Monash-BoSL/in_water_turbidity/README.md

# in_water_turbidity-
a repository for our in water turbidity sensor
