Monash-BoSL/in_water_turbidity/(commit log)

2023-07-21 added BOM
    [turbidity_sensor_v2.kicad_sch]
2023-07-21 added missing parts
    [turbidity_sensor_v2.kicad_sch]
2023-07-21 fixed short and updated TPS2552 symbol+package
    [turbidity_sensor_v2.kicad_sch]
2023-08-04 finished pcb design
    [turbidity_sensor_v2.kicad_pcb]
2023-08-04 fixed design clearance errors
    [turbidity_sensor_v2.kicad_pcb]
2023-08-04 copper pour improved
    [turbidity_sensor_v2.kicad_pcb]
2023-08-04 Revert "copper pour improved"
    This reverts commit 2f328d1ea783174a544840e6c5c3d9fd8c94ad71.
    [turbidity_sensor_v2.kicad_pcb]
2023-08-04 Revert "fixed design clearance errors"
    This reverts commit 14c126d1d8ca6f358af7ff198aae8262362c5089.
    [turbidity_sensor_v2.kicad_pcb]
2023-08-04 Revert "finished pcb design"
    This reverts commit 5361b876c939f7b8e245db1d6caf93f7ae87d99f.
    [turbidity_sensor_v2.kicad_pcb]
2023-08-04 Revert "ripup"
    This reverts commit 3bb3fa60b669a7bda381ab3e7e510d79c512a6db.
    [turbidity_sensor_v2.kicad_pcb, turbidity_sensor_v2.kicad_sch]
2023-08-04 Revert "pcb"
    This reverts commit 522b0ccb23680a7af5352e0b4cae910c8f3d24e6.
    [turbidity_sensor_v2.kicad_pcb, turbidity_sensor_v2.kicad_sch]
2023-08-04 Revert "Merge remote-tracking branch 'origin/master' into pcb"
    This reverts commit b7623a8f51a11bc868f84ff51483eb2e2d624007, reversing
    changes made to ddd9f51137c8f737cef688a815be375d05de5119.
    [turbidity_sensor_v2.kicad_pcb, turbidity_sensor_v2.kicad_sch]
2023-08-05 fixed 3.3V unrouted error
    [turbidity_sensor_v2.kicad_pcb]
2023-08-05 removed ground/power plane above and around TIA
    [turbidity_sensor_v2.kicad_pcb]
2023-08-05 fixed keep out zones warning about vias
    [turbidity_sensor_v2.kicad_pcb]
2023-08-06 thanks for this, I have gone through and made a few changes: *added thermal relief around all pads. *made the In2.Cu fill zone square (if there was a reason it had this shape feel free to revert the 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
    my main comment is that the connection comming out of a pad should be smaller than the pad itself. Otherwise it can cause issues with soldering and long term thermal reliablity issues.
    Please revise:
    C24 and R6 need to be placed next to each other with grounds connected. (not unconnected at the moment)
    Place reference designators of integrate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
    [turbidity_sensor_v2.kicad_pcb, turbidity_sensor_v2.kicad_sch]
2023-08-10 repaired silkscreen and placement of C24 and R6
    [turbidity_sensor_v2.kicad_pcb, turbidity_sensor_v2.kicad_sch]
2023-08-10 added thermal relief
    [turbidity_sensor_v2.kicad_pcb, turbidity_sensor_v2.kicad_sch]
2023-08-11 added production files
    [turbidity_sensor_v2-B_Cu.gbr, turbidity_sensor_v2-B_Mask.gbr, turbidity_sensor_v2-B_Paste.gbr, turbidity_sensor_v2-B_Silkscreen.gbr, turbidity_sensor_v2-Edge_Cuts.gbr, turbidity_sensor_v2-F_Cu.gbr, turbidity_sensor_v2-F_Mask.gbr, turbidity_sensor_v2-F_Paste.gbr]
2023-09-08 Fixed incorrect 8mhz oscillator
    [turbidity_sensor_v2.kicad_pcb]
2023-09-08 Updated production files
    [turbidity_sensor_v2-B_Cu.gbr, turbidity_sensor_v2-B_Mask.gbr, turbidity_sensor_v2-B_Paste.gbr, turbidity_sensor_v2-B_Silkscreen.gbr, turbidity_sensor_v2-Edge_Cuts.gbr, turbidity_sensor_v2-F_Cu.gbr, turbidity_sensor_v2-F_Mask.gbr, turbidity_sensor_v2-F_Paste.gbr]
